travis26pdx/LowPowerSensorSuite/images/PCB_v1.0_build.jpg

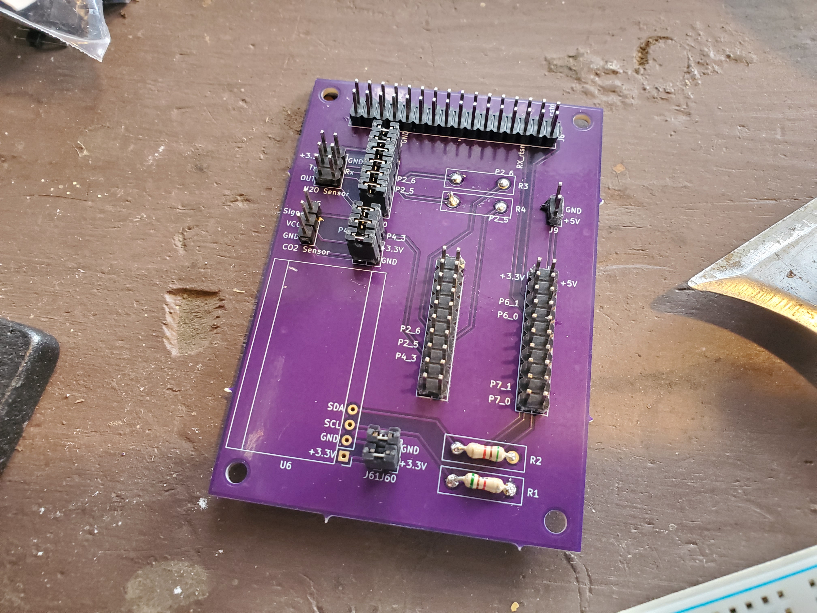
images/PCB_v1.0_build.jpg
