travis26pdx/LowPowerSensorSuite/images/20220415_EnergyTrace_setup.jpg

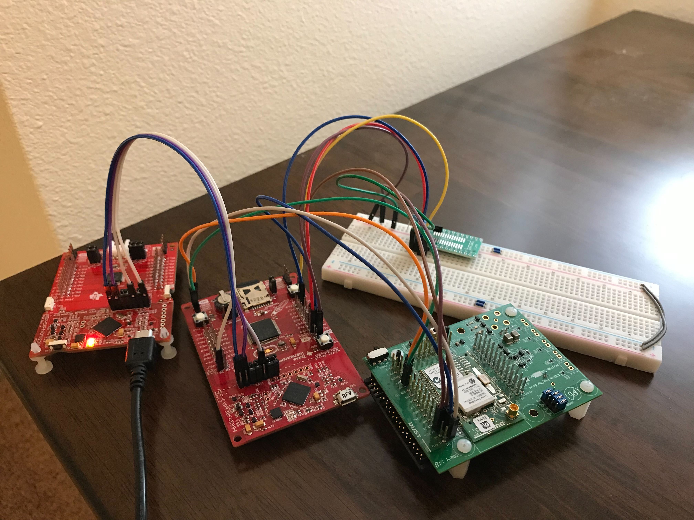
images/20220415_EnergyTrace_setup.jpg
