travis26pdx/LowPowerSensorSuite/README.md

# LowPowerSensorSuite
Repository for 2022 Capstone: 2nd Gen Low Power Environmental Sensor Suite

# Contents
The following are the contents of this repository.
