travis26pdx/LowPowerSensorSuite/Design/readme.md

These folders contain the design files including:
1. KiCad files
2. CAD file for base board
