travis26pdx/LowPowerSensorSuite/Documentation/GANTT_ledger.pdf

1 3 | 10 | 17 | 24 | 31 | 7 | 14 | 21 | 28 | 7 | 14 | 21 | 28 | 4 | 11 | 18 | 25 | 2 | 9 | 16 | 23 | 30 | 6
| | 1/22 | | | | 2/22 | | | | 3/22 | | | | | 4/22 | | | | 5/22 | | | 6/22

## Sensor Suite

Preliminary Research
Review previous Capstone
Write Product Specification
Write Project Proposal
Project Proposal Signed and Submitt...

MSP430
Connect with SmartMesh IP
Code mote to transmit data to co... Connect SmartMesh to MSp430 Code mote to transmit sensor data ... Debug Code
Working Code
Data Storage
Research / Code Proof of concept Data Write / Read
Write sensor data
Debug Code
Final Code
Low Power mode
Research / Code Proof of concept Wake / Sleep cycle
Optimize and Debug Code
Final Code

Code Full Cycle Program
Rough full cycle
Debugged and Optimized
Final code

GUI Development
GUI displays live data
Display timestamps for data
Display status of operation of motes Display Graphical representation of ... Debug Code
Final Code

Sensors
Get Sensor Data
Get temp/humidity data from sens... Get NO2 data from sensor
Characterize sensors
Characterize temp/humidity sensors Characterize NO2 sensor

Breadboard Prototyping
Rough schematic
Build mote on breadboard
Bill of Materials

PCB Prototyping
Final schematic
PCB Layout
Place 1st order PCBs
Build 1st PCB
Place 2nd order of PCBs (if needed) Build 2nd PCB
Minimal Viable Product

Enclosure
Design weather resistant enclosure Purchase materials
Finalize enclosure
Install mote into enclosure Demonstrable Device

Testing
Write test plans
Perform test plans
Testing Completed

Documentation
Github collab site completed Write rough operations guide Write final operations guide Complete Capstone Poster
Capstone poster event
Produce stakeholder report Write rough final report
Write final report
Final Report Presentation

Preliminary Research
Review previous Capstone :: All
Write Product Specification :: All Write Project Proposal :: All
Project Proposal Signed and Submitted :: All

MSP430
Connect with SmartMesh IP
Code mote to transmit data to computer :: Eyal, Wei Connect SmartMesh to MSp430 :: Eyal, Wei
Code mote to transmit sensor data from MSP430 to PC :: Eyal, Wei Debug Code :: Eyal, Wei
Working Code :: Eyal, Wei
Data Storage
Research / Code Proof of concept :: Travis, Wei Data Write / Read :: Travis, Wei
Write sensor data :: Travis, Wei Debug Code :: Travis, Wei
Final Code :: Travis, Wei
Low Power mode
Research / Code Proof of concept :: Travis, Wei Wake / Sleep cycle :: Travis, Wei
Optimize and Debug Code :: Travis, Wei Final Code :: Travis, Wei

Code Full Cycle Program
Rough full cycle :: Travis, Wei
Debugged and Optimized :: Travis, Wei Final code

GUI Development
GUI displays live data :: Eyal, Wenyu
Display timestamps for data :: Eyal, Wenyu Display status of operation of motes :: Eyal, Wenyu Display Graphical representation of data :: Eyal, Wenyu Debug Code :: Eyal, Wenyu
Final Code :: Eyal, Wenyu

Sensors
Get Sensor Data
Get temp/humidity data from sensors :: Wenyu Get NO2 data from sensor :: Wenyu
Characterize sensors
Characterize temp/humidity sensors :: Wenyu Characterize NO2 sensor :: Wenyu

Breadboard Prototyping
Rough schematic :: Travis, Wei
Build mote on breadboard :: Travis, Wei Bill of Materials :: Travis

PCB Prototyping
Final schematic :: Travis, Wei
PCB Layout :: Travis, Wei
Place 1st order PCBs :: Travis
Build 1st PCB :: All
Place 2nd order of PCBs (if needed) :: Travis Build 2nd PCB :: All
Minimal Viable Product :: All

Enclosure
Design weather resistant enclosure :: Wenyu Purchase materials :: Wenyu
Finalize enclosure :: Wenyu Install mote into enclosure :: Wenyu Demonstrable Device

Testing
Write test plans :: Eyal, Wenyu Perform test plans :: Eyal, Wenyu Testing Completed :: Eyal, Wenyu

Documentation
Github collab site completed :: All Write rough operations guide :: All Write final operations guide :: All Complete Capstone Poster :: All Capstone poster event
Produce stakeholder report :: All
Write rough final report :: All Write final report :: All
Final Report Presentation

Powered by TCPDF (www.tcpdf.org)
