travis26pdx/LowPowerSensorSuite/N2O/P2.5&P2.6 serial port configuration document.pdf

Connect the serial port module and MSP430 to the computer, connect TX to 2.6, RX to 2.5, connect to GND, and do not connect the rest of the wires.

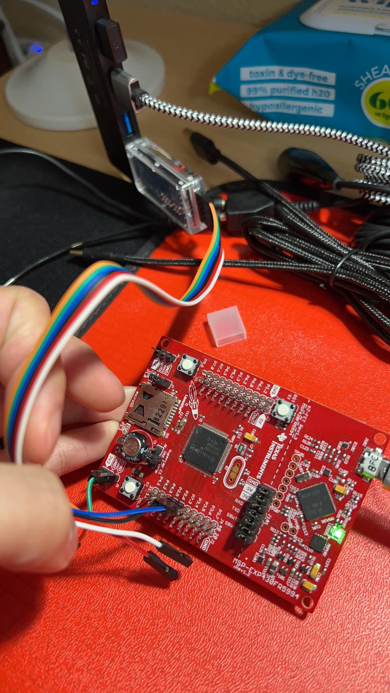
[picture p13: figure]
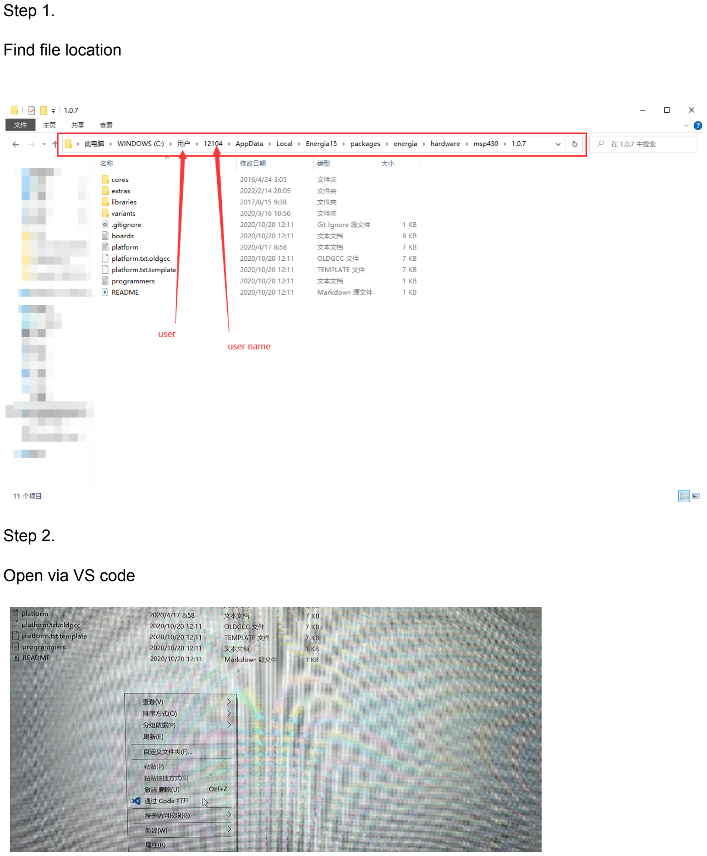
[picture p14: page 2]

Step 1.

Find file location

Step 2.

Open via VS code

Step 3.

variants→MSP-EXP430FR5994LP→pins_energia.h→line 97 & 98

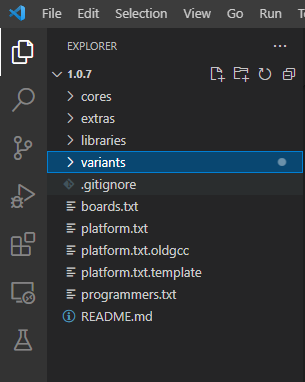
[picture p15: figure]
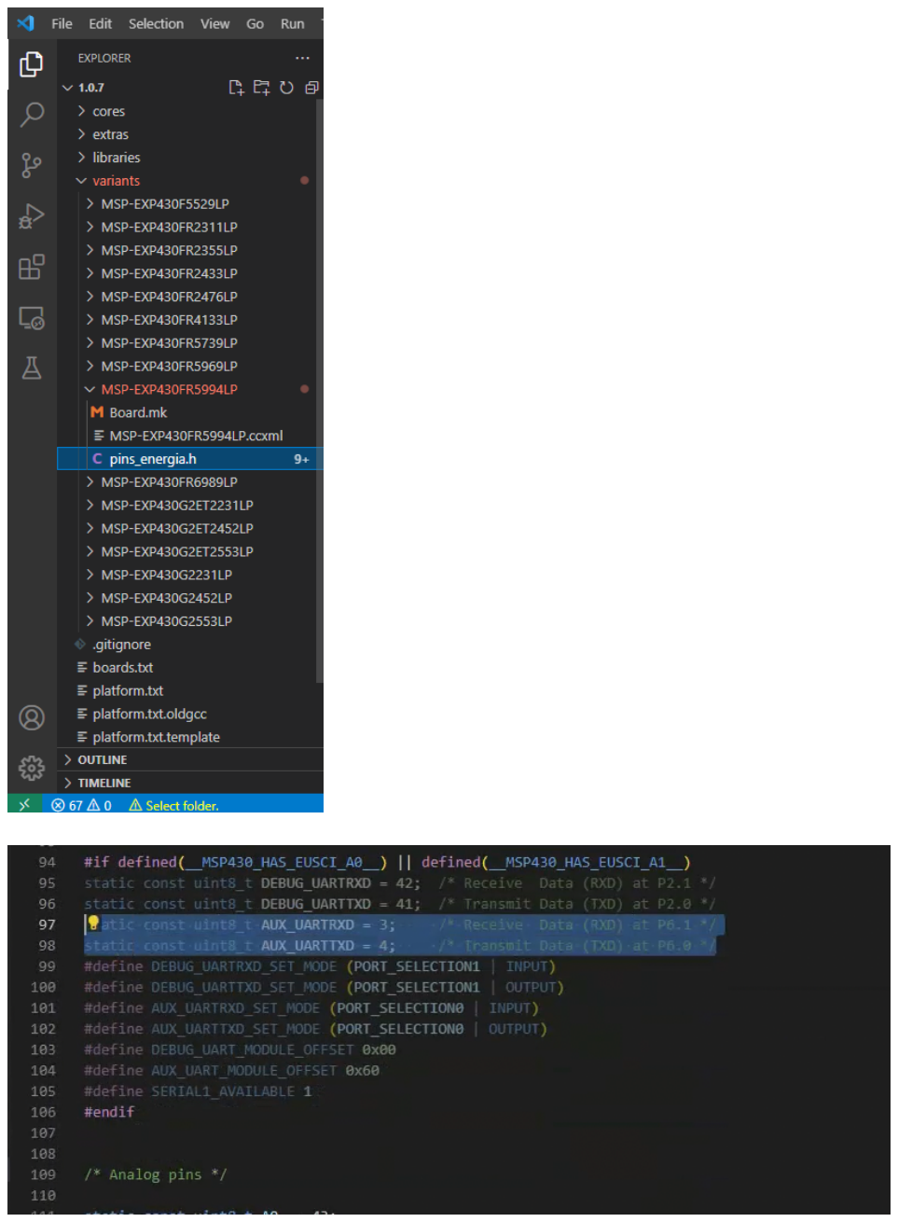
[picture p16: page 4]
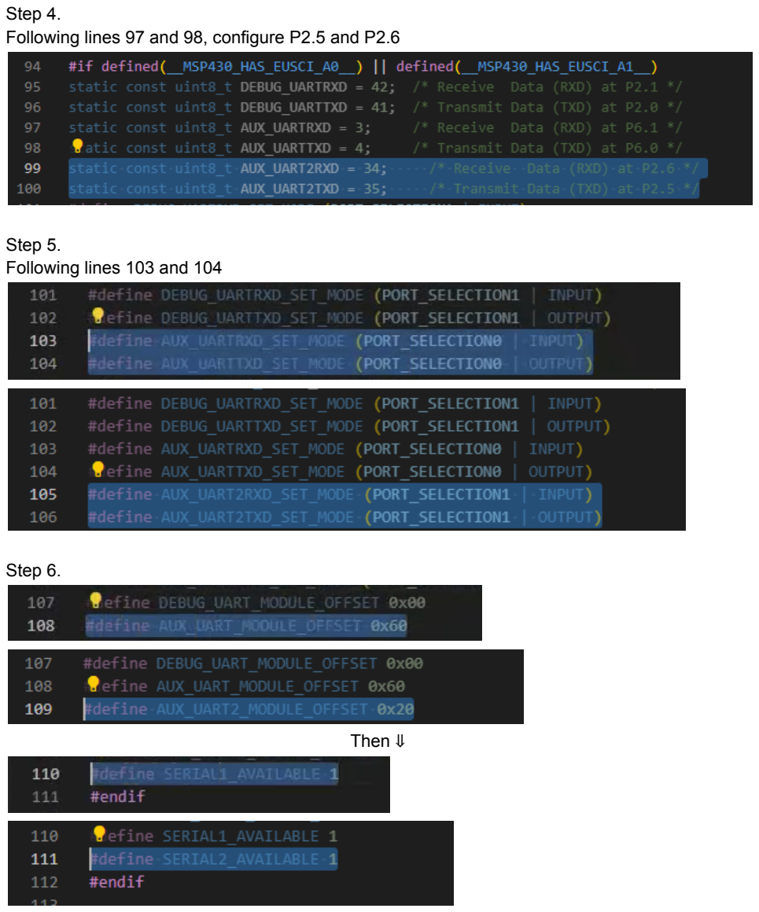
[picture p17: page 5]

Step 4.
Following lines 97 and 98, configure P2.5 and P2.6
Step 5.
Following lines 103 and 104
Step 6.

Then ⇓

Step 7.
cores →HardwareSerial.cpp→line 87-90

⇓

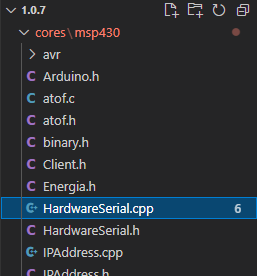
[picture p18: figure]
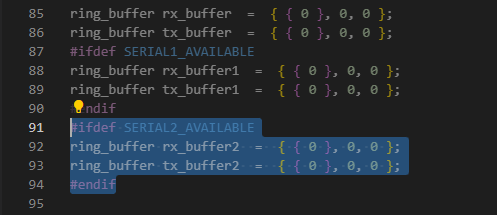
[picture p19: figure]
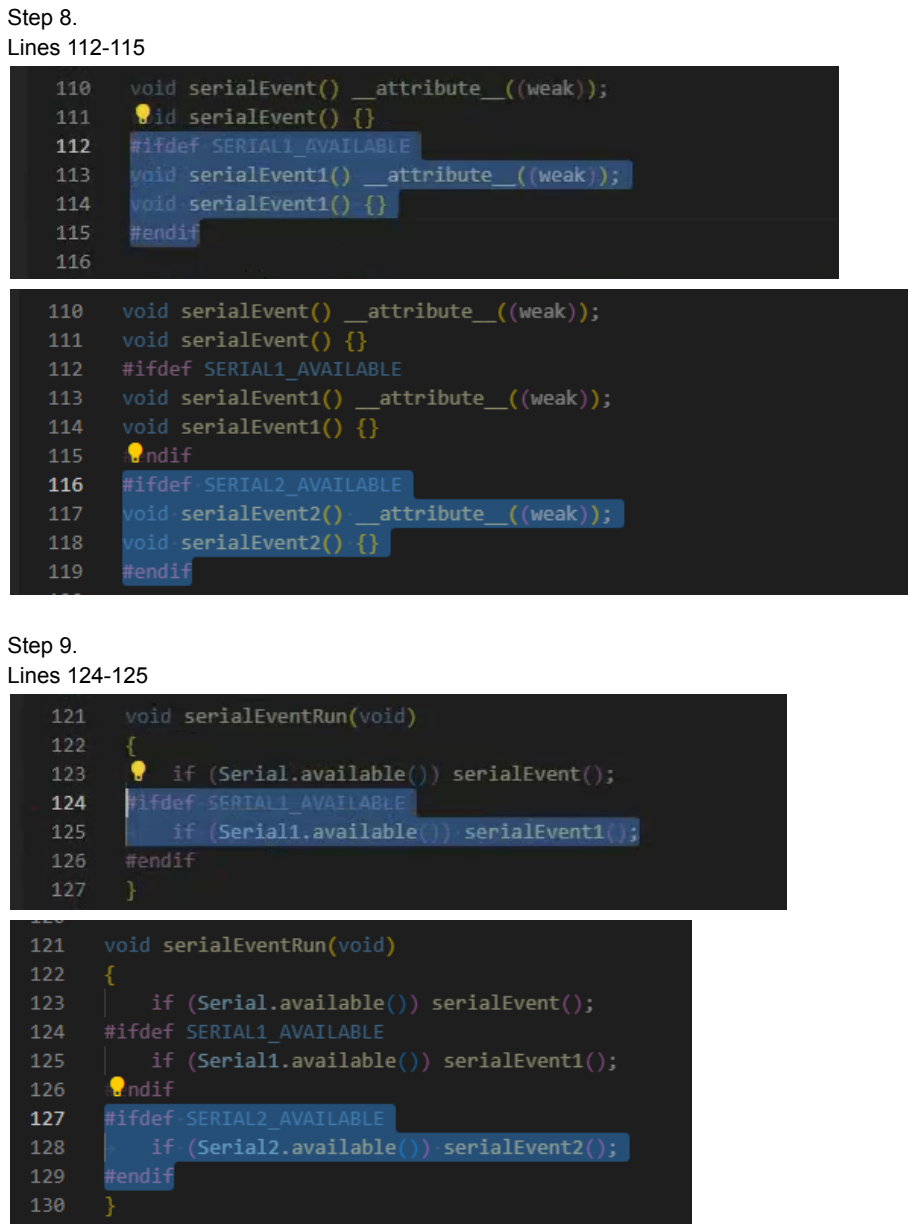
[picture p20: page 7]

Step 8.
Lines 112-115
Step 9.
Lines 124-125

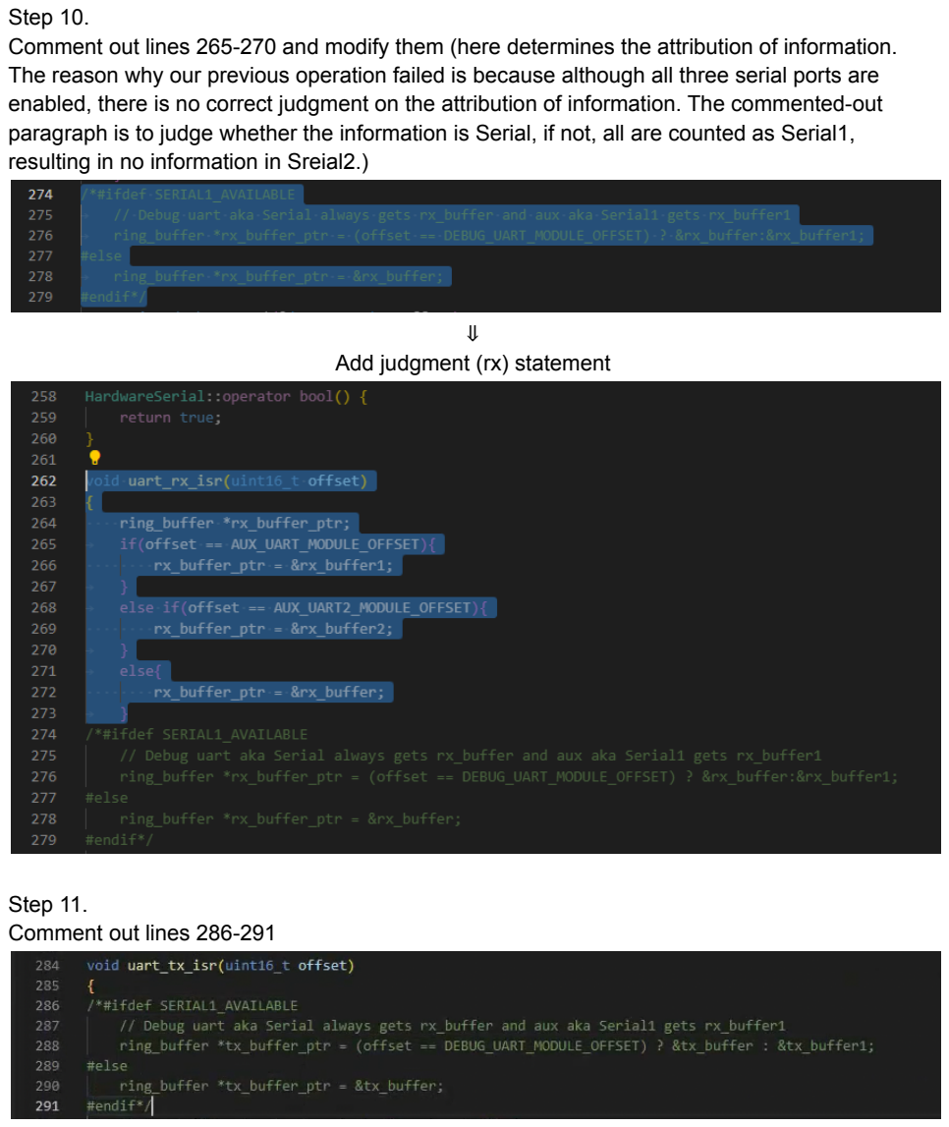
[picture p21: page 8]

Step 10.
Comment out lines 265-270 and modify them (here determines the attribution of information. The reason why our previous operation failed is because although all three serial ports are enabled, there is no correct judgment on the attribution of information. The commented-out paragraph is to judge whether the information is Serial, if not, all are counted as Serial1, resulting in no information in Sreial2.)

⇓
Add judgment (rx) statement
Step 11.
Comment out lines 286-291

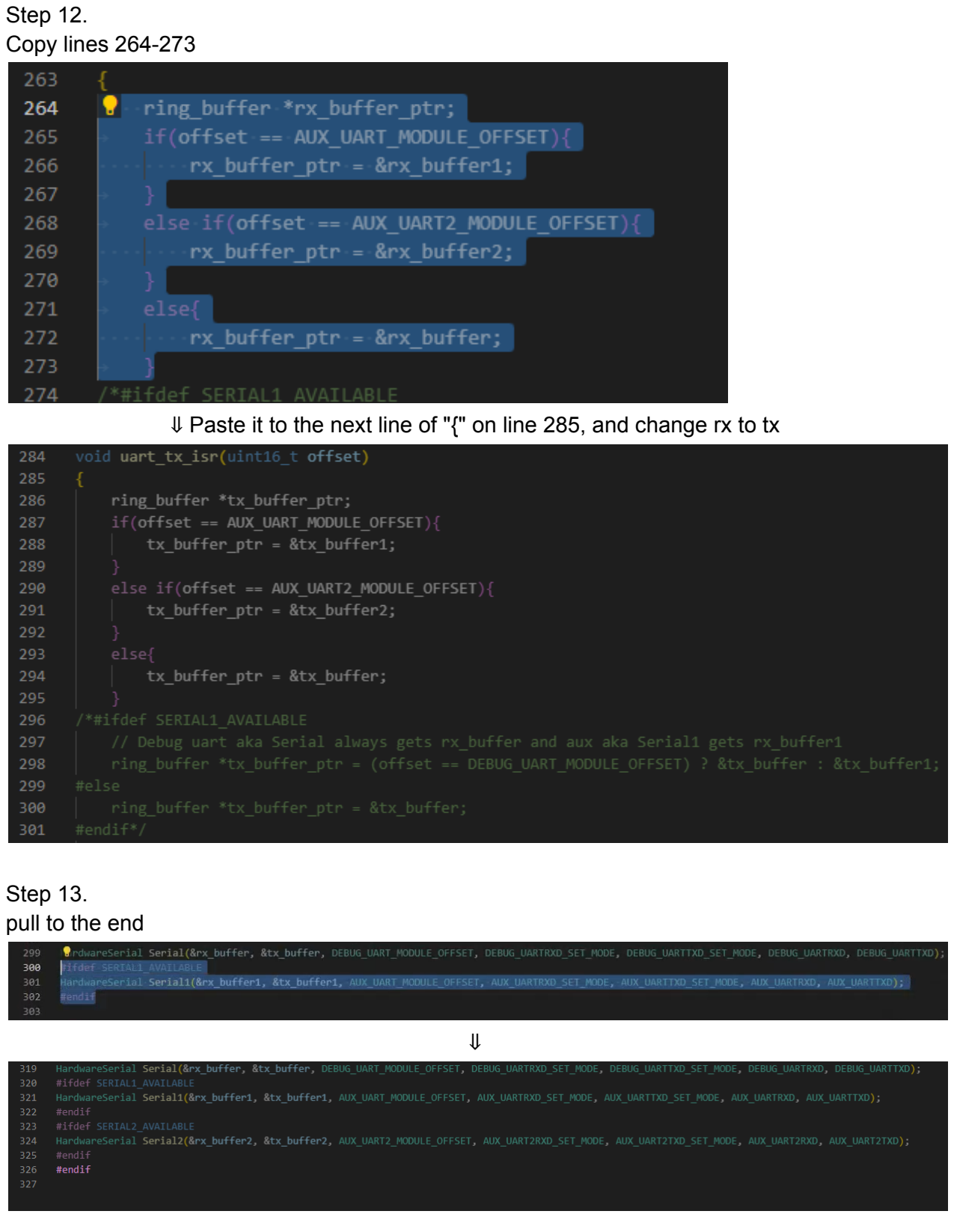
[picture p22: page 9]

Step 12.
Copy lines 264-273

⇓ Paste it to the next line of "{" on line 285, and change rx to tx

Step 13.
pull to the end

⇓

Step 14.
HardwareSerial.h→line 100

⇓

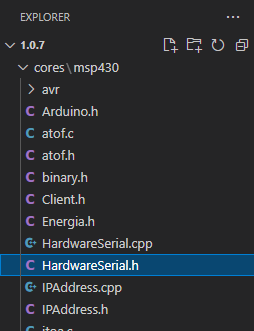
[picture p23: figure]
