travis26pdx/LowPowerSensorSuite/Documentation/PreviousYear/readme.md

This folder contains the deliverables from last year's Capstone team who built the 1st Gen low power environmental sensor suite.
