travis26pdx/LowPowerSensorSuite/Design/baseboard_mm.png

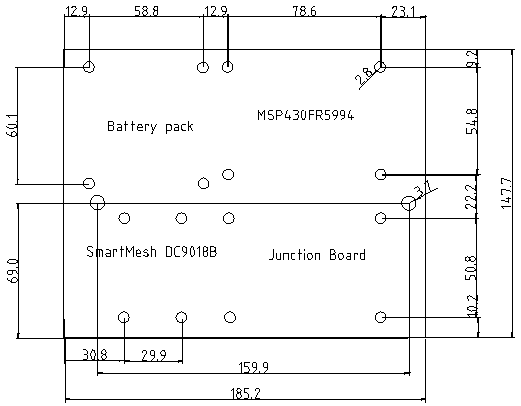
Design/baseboard_mm.png
