travis26pdx/LowPowerSensorSuite/images/20220415_EnergyTrace_Graph.PNG

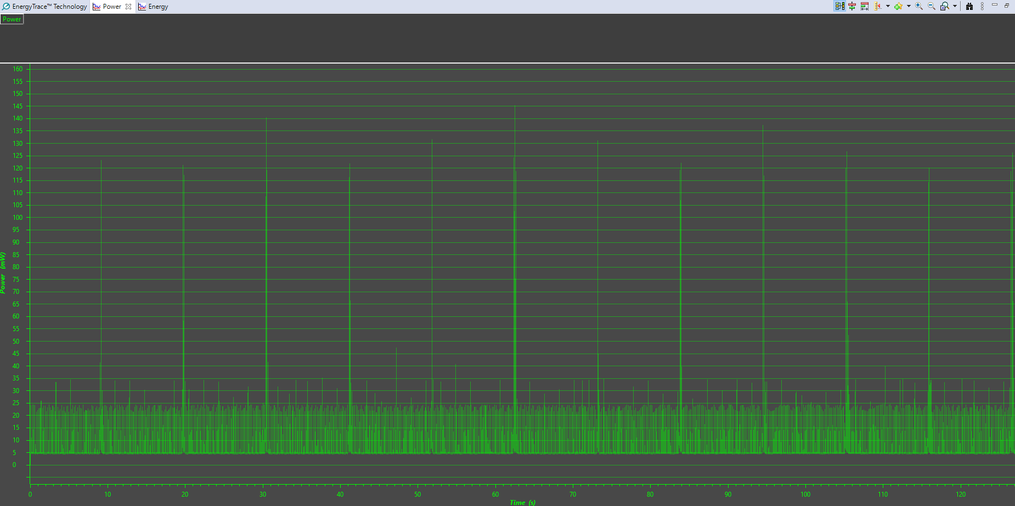
images/20220415_EnergyTrace_Graph.PNG
