travis26pdx/LowPowerSensorSuite/images/circuitboard.png

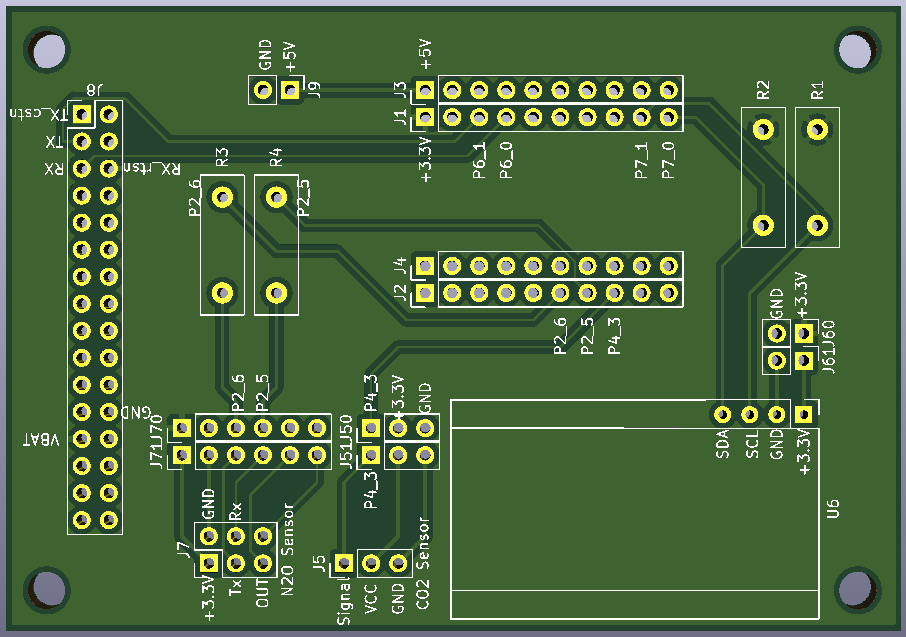
images/circuitboard.png
