travis26pdx/LowPowerSensorSuite/images/complete_mote.jpg

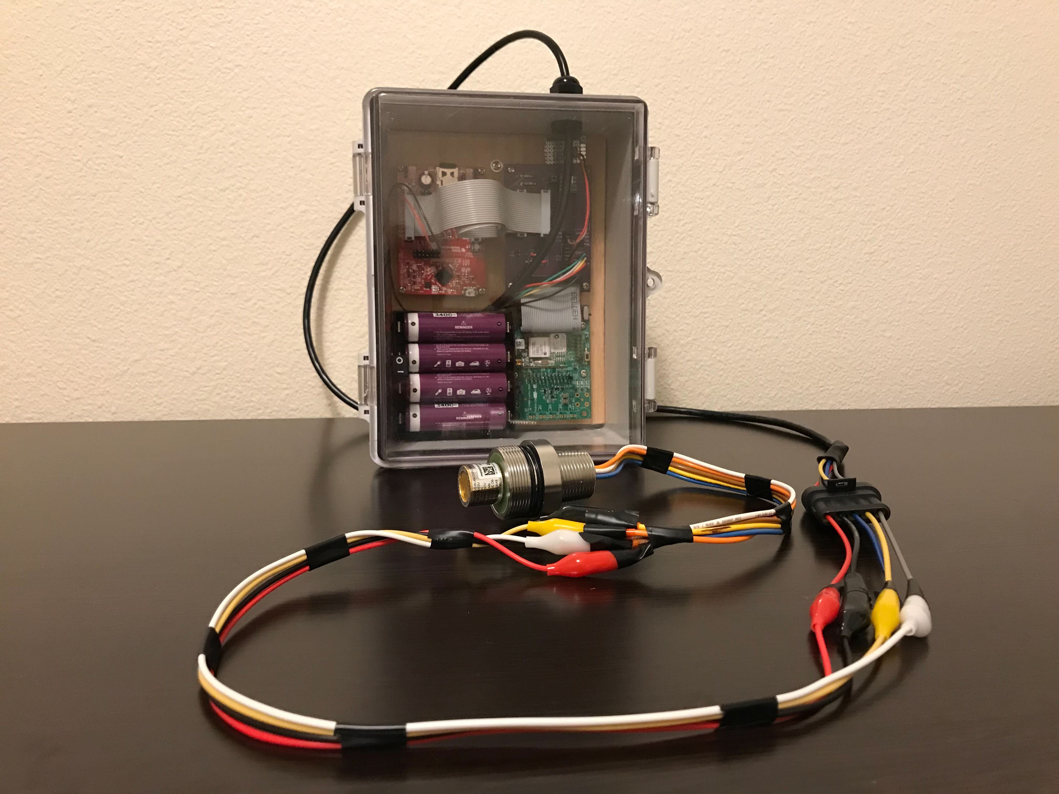
images/complete_mote.jpg
