travis26pdx/LowPowerSensorSuite/images/fullmote01.jpg

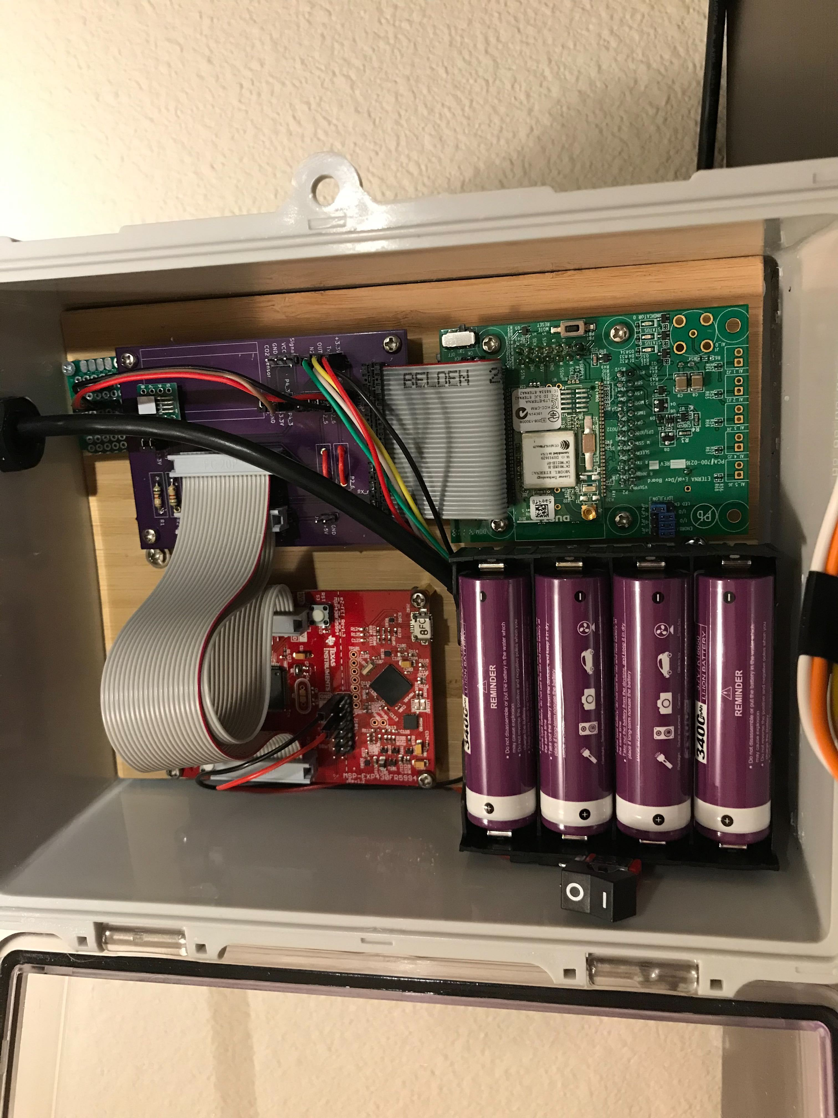
images/fullmote01.jpg
