travis26pdx/LowPowerSensorSuite/BOM/readme.md

This folder contains 2 Bills of Materials.
1. BOM for the entire project
2. BOM for the PCB
