travis26pdx/LowPowerSensorSuite/Design/SensorSuiteBoard/pcb.pdf

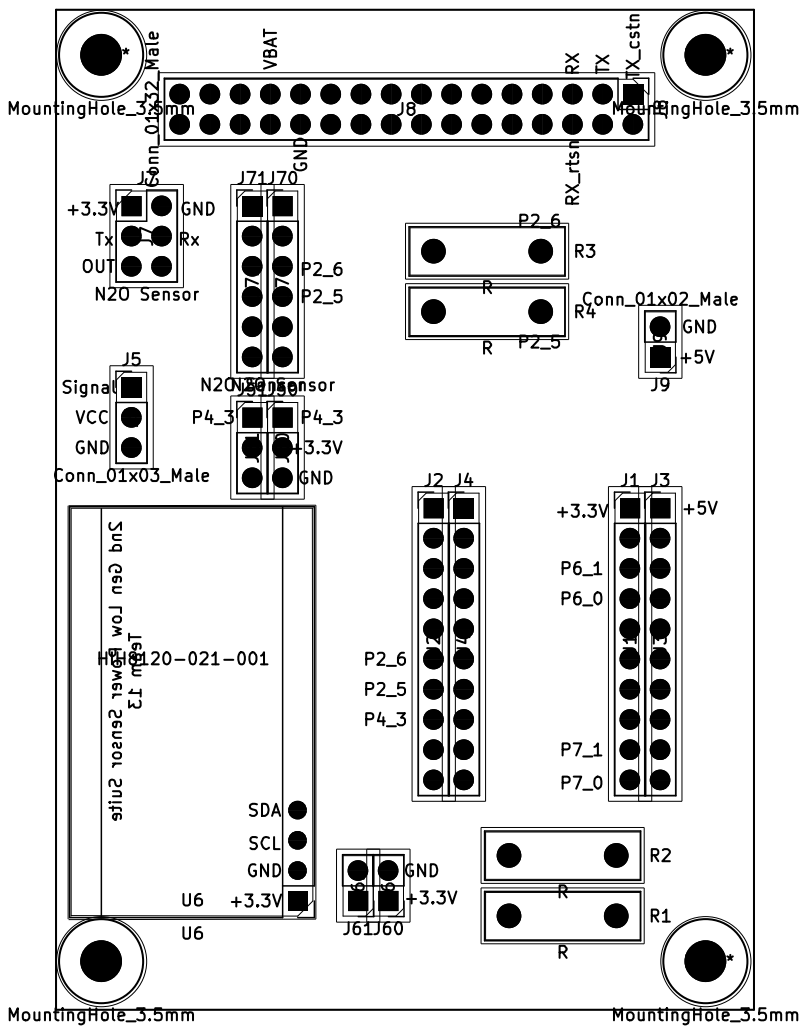
[picture p29: page 1]
