travis26pdx/LowPowerSensorSuite/Design/SensorSuiteBoard/SensorSuiteBoard.kicad_pcb

## KiCad design Design/SensorSuiteBoard/SensorSuiteBoard.kicad_pcb (2022-06-10)

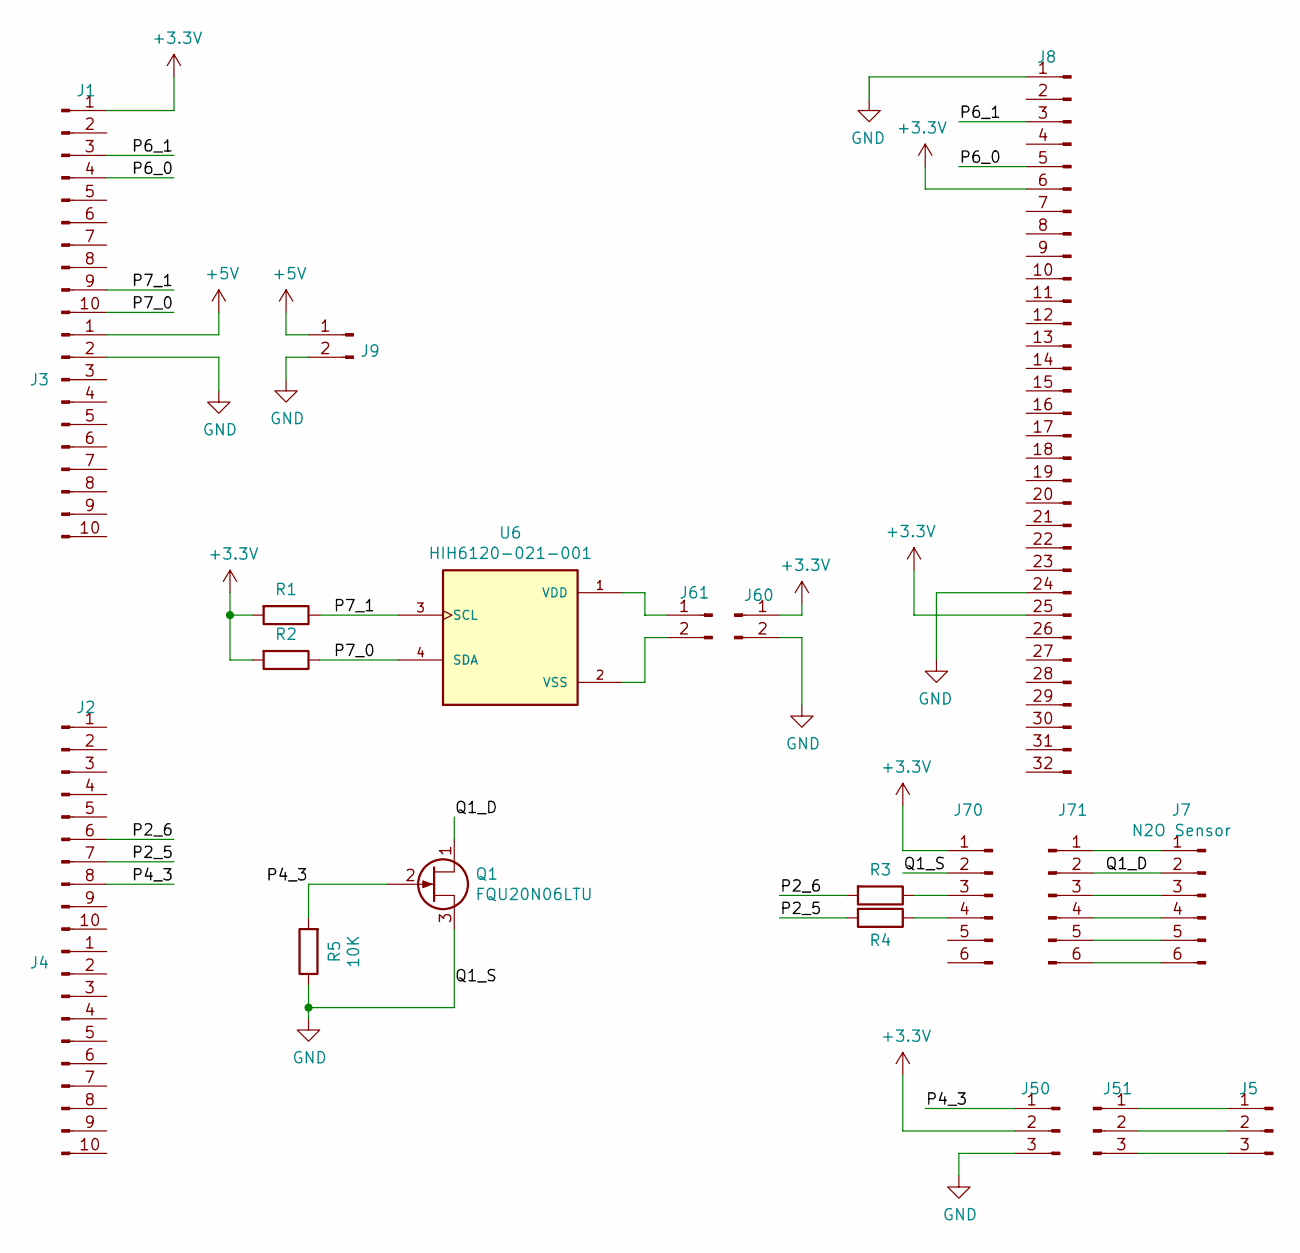
[picture p30: schematic SensorSuiteBoard.sch, Low Power Sensor Suite Junction Board]

Parts:
J1, J2, J3, J4: Conn_01x10_Male; Pin_Header_Straight_1x10_Pitch2.54mm
J5, J50, J51: Conn_01x03_Male; Pin_Header_Straight_1x03_Pitch2.54mm
J7: N2O Sensor; Pin_Header_Straight_2x03_Pitch2.54mm
J8: Conn_01x32_Male; Pin_Header_Straight_2x16_Pitch2.54mm
J9, J60, J61: Conn_01x02_Male; Pin_Header_Straight_1x02_Pitch2.54mm
J70, J71: N2O Sensor; Pin_Header_Straight_1x06_Pitch2.54mm
Q1: FQU20N06LTU
R1, R2, R3, R4: R; R_Box_L13.0mm_W4.0mm_P9.00mm
R5: 10K; R_Box_L13.0mm_W4.0mm_P9.00mm
U6: HIH6120-021-001; HIH8120_breakout

Connections:
+3V3: J1.1, J8.6, J8.25, J50.2, J60.1, J70.1, R1.2, R2.2
+5V: J3.1, J9.1
/P2_5: J2.7, R4.2
/P2_6: J2.6, R3.2
/P4_3: J2.8, J50.1, Q1.2 (G), R5.2
/P6_0: J1.4, J8.5
/P6_1: J1.3, J8.3
/P7_0: J1.10, R2.1, U6.4 (SDA)
/P7_1: J1.9, R1.1, U6.3 (SCL)
GND: J3.2, J8.1, J8.24, J9.2, J50.3, J60.2, J70.2, Q1.3 (S), R5.1
unnamed: J5.1, J51.1
unnamed: J5.2, J51.2
unnamed: J5.3, J51.3
unnamed: J7.1, J71.1
unnamed: J7.2, J71.2, Q1.1 (D)
unnamed: J7.3, J71.3
unnamed: J7.4, J71.4
unnamed: J7.5, J71.5
unnamed: J7.6, J71.6
unnamed: J61.1, U6.1 (VDD)
unnamed: J61.2, U6.2 (VSS)
unnamed: J70.3, R3.1
unnamed: J70.4, R4.1

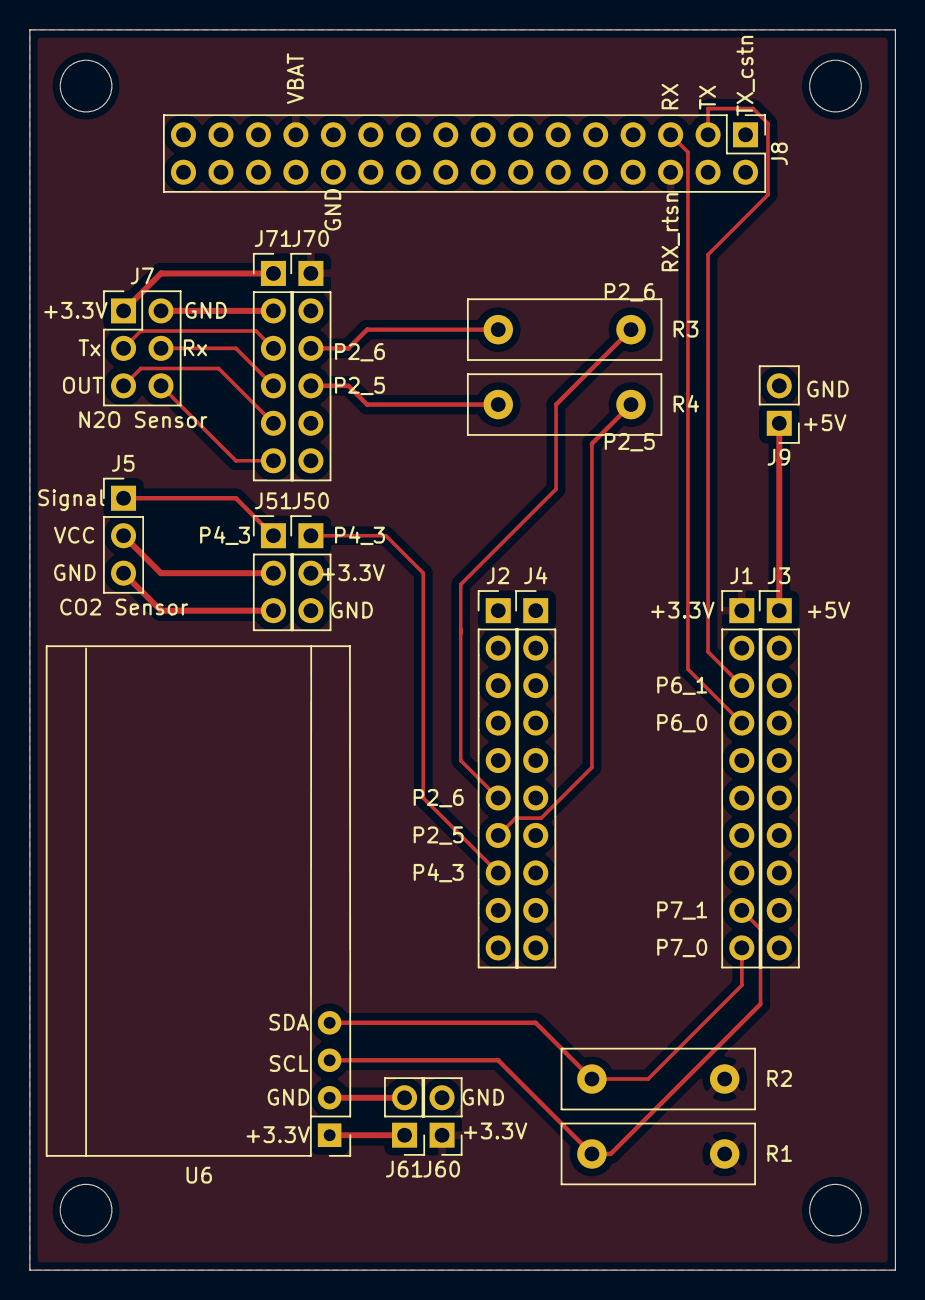
[picture p31: board SensorSuiteBoard.kicad_pcb from above]

Board: 2 copper layers, 58.7 x 84.1 mm, 19 parts (0 on the bottom side), 23 nets.
