travis26pdx/LowPowerSensorSuite/Firmware/Temp Humidity Sensor Fix/msp430-lg-core-master/variants/MSP-EXP430FR2355LP/pins_energia.h

#define Pins_Energia_h
#define BV(x) (1 << (x))
#include <msp430fr2xx_4xxgeneric.h>
#define PLACE_IN_FRAM __attribute__((section(".text;")))
#if defined(__MSP430_HAS_EUSCI_B0__)
static const uint8_t SS1      = 8;
static const uint8_t SCK1     = 7;
static const uint8_t MOSI1    = 15;
static const uint8_t MISO1    = 14;
static const uint8_t TWISCL0  = 9;
static const uint8_t TWISDA0  = 10;
static const uint8_t TWISDA1  = 15;
static const uint8_t TWISCL1  = 14;
#define TWISDA0_SET_MODE  (PORT_SELECTION0 | INPUT_PULLUP)
#define TWISCL0_SET_MODE  (PORT_SELECTION0 | INPUT_PULLUP)
#define TWISDA1_SET_MODE  (PORT_SELECTION0 | INPUT_PULLUP)
#define TWISCL1_SET_MODE  (PORT_SELECTION0 | INPUT_PULLUP)
#define SPISCK1_SET_MODE  (PORT_SELECTION0)
#define SPIMOSI1_SET_MODE (PORT_SELECTION0)
#define SPIMISO1_SET_MODE (PORT_SELECTION0)
#define DEFAULT_SPI 1
#define SS    SS1
#define SCK   SCK1
#define MOSI  MOSI1
#define MISO  MISO1
#define SPISCK_SET_MODE  SPISCK1_SET_MODE
#define SPIMOSI_SET_MODE SPIMOSI1_SET_MODE
#define SPIMISO_SET_MODE SPIMISO1_SET_MODE
#define DEFAULT_I2C 0
#define TWISDA TWISDA0
#define TWISCL TWISCL0
#define TWISDA_SET_MODE  TWISDA0_SET_MODE
#define TWISCL_SET_MODE  TWISCL0_SET_MODE
#endif
#if defined(__MSP430_HAS_EUSCI_A0__) || defined(__MSP430_HAS_EUSCI_A1__)
static const uint8_t DEBUG_UARTRXD = 42;
static const uint8_t DEBUG_UARTTXD = 41;
static const uint8_t AUX_UARTRXD = 3;
static const uint8_t AUX_UARTTXD = 4;
#define DEBUG_UARTRXD_SET_MODE (PORT_SELECTION0 | INPUT)
#define DEBUG_UARTTXD_SET_MODE (PORT_SELECTION0 | OUTPUT)
#define AUX_UARTRXD_SET_MODE (PORT_SELECTION0 | INPUT)
#define AUX_UARTTXD_SET_MODE (PORT_SELECTION0 | OUTPUT)
#define DEBUG_UART_MODULE_OFFSET 0x80
#define AUX_UART_MODULE_OFFSET 0x00
#define SERIAL1_AVAILABLE 1
#endif
#define DEFAULT_TIMER 13
#define INIT_LFXTAL_PINS P2SEL0 = BIT6 | BIT7
static const uint8_t A0  = 43;
static const uint8_t A1  = 28;
static const uint8_t A2  = 10;
static const uint8_t A3  = 9;
static const uint8_t A4  = 23;
static const uint8_t A5  = 2;
static const uint8_t A6  = 3;
static const uint8_t A7  = 4;
static const uint8_t A8  = 26;
static const uint8_t A9  = 25;
static const uint8_t A10 = 6;
static const uint8_t A11 = 24;
static const uint8_t A12 = 128 + 12; // Not available on BoosterPack header
static const uint8_t A13 = 128 + 13; // Not available on BoosterPack header
static const uint8_t A14 = 128 + 14; // Not available on BoosterPack header
static const uint8_t A15 = 128 + 15; // Not available on BoosterPack header
static const uint8_t P1_0 = 43;
static const uint8_t P1_1 = 28;
static const uint8_t P1_2 = 10;
static const uint8_t P1_3 = 9;
static const uint8_t P1_4 = 23;
static const uint8_t P1_5 = 2;
static const uint8_t P1_6 = 3;
static const uint8_t P1_7 = 4;
static const uint8_t P2_0 = 19;
static const uint8_t P2_1 = 40;
static const uint8_t P2_2 = 18;
static const uint8_t P2_3 = 46;
static const uint8_t P2_4 = 33;
static const uint8_t P2_5 = 12;
static const uint8_t P3_0 = 11;
static const uint8_t P3_1 = 30;
static const uint8_t P3_2 = 31;
static const uint8_t P3_3 = 32;
static const uint8_t P3_4 = 8;
static const uint8_t P3_5 = 29;
static const uint8_t P3_6 = 5;
static const uint8_t P3_7 = 34;
static const uint8_t P4_0 = 17;
static const uint8_t P4_1 = 45;
static const uint8_t P4_2 = 42;
static const uint8_t P4_3 = 41;
static const uint8_t P4_4 = 13;
static const uint8_t P4_5 = 7;
static const uint8_t P4_6 = 15;
static const uint8_t P4_7 = 14;
static const uint8_t P5_0 = 26;
static const uint8_t P5_1 = 25;
static const uint8_t P5_2 = 6;
static const uint8_t P5_3 = 24;
static const uint8_t P5_4 = 27;
static const uint8_t P6_0 = 39;
static const uint8_t P6_1 = 38;
static const uint8_t P6_2 = 37;
static const uint8_t P6_3 = 36;
static const uint8_t P6_4 = 35;
static const uint8_t P6_6 = 44;
static const uint8_t LED1 = 43;
static const uint8_t LED2 = 44;
static const uint8_t RED_LED = 43;
static const uint8_t GREEN_LED = 44;
static const uint8_t PUSH1 = 45;
static const uint8_t PUSH2 = 46;
static const uint8_t TEMPSENSOR = 128 + 12; // depends on chip
#ifdef ARDUINO_MAIN
const uint16_t port_to_input[] = {
   NOT_A_PORT,
   (uint16_t) (P1_BASE+OFS_P1IN),
   (uint16_t) (P2_BASE+OFS_P2IN),
#ifdef __MSP430_HAS_PORT3_R__
   (uint16_t) (P3_BASE+OFS_P3IN),
#endif
#ifdef __MSP430_HAS_PORT4_R__
   (uint16_t) (P4_BASE+OFS_P4IN),
#endif
#ifdef __MSP430_HAS_PORT5_R__
   (uint16_t) (P5_BASE+OFS_P5IN),
#endif
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
        NOT_ON_ADC,
        NOT_ON_ADC,
        NOT_ON_ADC,
        NOT_ON_ADC,
        NOT_ON_ADC,
        NOT_ON_ADC,
        NOT_ON_ADC,
        NOT_ON_ADC,
        NOT_ON_ADC,
        NOT_ON_ADC,
        NOT_ON_ADC,
        0,
        NOT_ON_ADC,
        NOT_ON_ADC,
        NOT_ON_ADC,
};
#endif // #ifdef ARDUINO_MAIN
