travis26pdx/LowPowerSensorSuite/Firmware/Temp Humidity Sensor Fix/msp430-lg-core-master/variants/MSP-EXP430FR2433LP/pins_energia.h

#define Pins_Energia_h
#define BV(x) (1 << (x))
#include <msp430fr2xx_4xxgeneric.h>
#define PLACE_IN_FRAM __attribute__((section(".text;")))
static const uint8_t SS11     = 8;
static const uint8_t SCK11    = 7;
static const uint8_t MOSI11   = 15;
static const uint8_t MISO11   = 14;
static const uint8_t TWISDA0  = 10;
static const uint8_t TWISCL0  = 9;
static const uint8_t TWISDA1  = 15;
static const uint8_t TWISCL1  = 14;
#define TWISDA0_SET_MODE  (PORT_SELECTION0 | INPUT_PULLUP)
#define TWISCL0_SET_MODE  (PORT_SELECTION0 | INPUT_PULLUP)
#define TWISDA1_SET_MODE  (PORT_SELECTION0 | INPUT_PULLUP)
#define TWISCL1_SET_MODE  (PORT_SELECTION0 | INPUT_PULLUP)
#define SPISCK11_SET_MODE  (PORT_SELECTION0)
#define SPIMOSI11_SET_MODE (PORT_SELECTION0)
#define SPIMISO11_SET_MODE (PORT_SELECTION0)
#define DEFAULT_SPI 11
#define SS    SS11
#define SCK   SCK11
#define MOSI  MOSI11
#define MISO  MISO11
#define SPISCK_SET_MODE  SPISCK11_SET_MODE
#define SPIMOSI_SET_MODE SPIMOSI11_SET_MODE
#define SPIMISO_SET_MODE SPIMISO11_SET_MODE
static const uint8_t SS10     = 6;
static const uint8_t SCK10    = 5;
static const uint8_t MOSI10   = 4;
static const uint8_t MISO10   = 3;
#define SPISCK10_SET_MODE  (PORT_SELECTION0)
#define SPIMOSI10_SET_MODE (PORT_SELECTION0)
#define SPIMISO10_SET_MODE (PORT_SELECTION0)
#define DEFAULT_I2C 0
#define LEGACY_I2C  -1
#define TWISDA TWISDA0
#define TWISCL TWISCL0
#define TWISDA_SET_MODE  TWISDA0_SET_MODE
#define TWISCL_SET_MODE  TWISCL0_SET_MODE
#if defined(__MSP430_HAS_EUSCI_A0__) || defined(__MSP430_HAS_EUSCI_A1__)
static const uint8_t DEBUG_UARTRXD = 3;
static const uint8_t DEBUG_UARTTXD = 4;
static const uint8_t AUX_UARTRXD = 14;
static const uint8_t AUX_UARTTXD = 15;
#define DEBUG_UARTRXD_SET_MODE (PORT_SELECTION0 | INPUT)
#define DEBUG_UARTTXD_SET_MODE (PORT_SELECTION0 | OUTPUT)
#define DEBUG_UART_MODULE_OFFSET 0x00
#define AUX_UARTRXD_SET_MODE (PORT_SELECTION0 | INPUT)
#define AUX_UARTTXD_SET_MODE (PORT_SELECTION0 | OUTPUT)
#define AUX_UART_MODULE_OFFSET 0x20
#define SERIAL1_AVAILABLE 1
#endif
#define INIT_LFXTAL_PINS 	P2SEL0 = BIT0 | BIT1
static const uint8_t P1_0 = 2;
static const uint8_t P1_1 = 19;
static const uint8_t P1_2 = 10;
static const uint8_t P1_3 = 9;
static const uint8_t P1_4 = 4;
static const uint8_t P1_5 = 3;
static const uint8_t P1_6 = 5;
static const uint8_t P1_7 = 6;
static const uint8_t P2_0 = 11;
static const uint8_t P2_1 = 12;
static const uint8_t P2_2 = 18;
static const uint8_t P2_3 = 21;
static const uint8_t P2_4 = 7;
static const uint8_t P2_5 = 14;
static const uint8_t P2_6 = 15;
static const uint8_t P2_7 = 8;
static const uint8_t P3_0 = 22;
static const uint8_t P3_1 = 13;
static const uint8_t P3_2 = 17;
static const uint8_t LED1 = 2;
static const uint8_t LED2 = 19;
static const uint8_t RED_LED = 2;
static const uint8_t GREEN_LED = 19;
static const uint8_t PUSH1 = 21;
static const uint8_t PUSH2 = 8;
static const uint8_t TEMPSENSOR = 128 + 12; // depends on chip
static const uint8_t A0  = 2;
static const uint8_t A1  = 19;
static const uint8_t A2  = 10;
static const uint8_t A3  = 9;
static const uint8_t A4  = 4;
static const uint8_t A5  = 3;
static const uint8_t A6  = 5;
static const uint8_t A7  = 6;
static const uint8_t A8  = 128 + 8;  // Not available on FR2433
static const uint8_t A9  = 128 + 9;  // Not available on FR2433
static const uint8_t A10 = 128 + 10; // Not available on FR2433
static const uint8_t A11 = 128 + 11; // Not available on FR2433
static const uint8_t A12 = 128 + 12; // Not available on FR2433
static const uint8_t A13 = 128 + 13; // Not available on FR2433
static const uint8_t A14 = 128 + 14; // Not available on FR2433
static const uint8_t A15 = 128 + 15; // Not available on FR2433
#ifdef ARDUINO_MAIN
const uint16_t port_to_input[] = {
    NOT_A_PORT,
    (uint16_t) &P1IN,
    (uint16_t) &P2IN,
#ifdef __MSP430_HAS_PORT3_R__
    (uint16_t) &P3IN,
#endif
#ifdef __MSP430_HAS_PORT4_R__
    (uint16_t) &P4IN,
#endif
#ifdef __MSP430_HAS_PORT5_R__
    (uint16_t) &P5IN,
#endif
#ifdef __MSP430_HAS_PORT6_R__
    (uint16_t) &P6IN,
#endif
#ifdef __MSP430_HAS_PORT7_R__
    (uint16_t) &P7IN,
#endif
#ifdef __MSP430_HAS_PORT8_R__
    (uint16_t) &P8IN,
#endif
#ifdef __MSP430_HAS_PORTJ_R__
    (uint16_t) &PJIN,
#endif
};
const uint16_t port_to_output[] = {
    NOT_A_PORT,
    (uint16_t) &P1OUT,
    (uint16_t) &P2OUT,
#ifdef __MSP430_HAS_PORT3_R__
    (uint16_t) &P3OUT,
#endif
#ifdef __MSP430_HAS_PORT4_R__
    (uint16_t) &P4OUT,
#endif
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
    0,
    5,
    4,
    6,
    7,
    NOT_ON_ADC,
    NOT_ON_ADC,
    3,
    2,
    NOT_ON_ADC,
    NOT_ON_ADC,
    NOT_ON_ADC,
    NOT_ON_ADC,
    NOT_ON_ADC,
    NOT_ON_ADC,
    NOT_ON_ADC,
    NOT_ON_ADC,
    1,
    NOT_ON_ADC,
    NOT_ON_ADC,
    NOT_ON_ADC,
};
#endif // #ifdef ARDUINO_MAIN
