travis26pdx/LowPowerSensorSuite/Firmware/Temp Humidity Sensor Fix/msp430-lg-core-master/variants/MSP-EXP430FR2476LP/pins_energia.h

#define Pins_Energia_h
#define BV(x) (1 << (x))
#include <msp430fr2xx_4xxgeneric.h>
#define PLACE_IN_FRAM __attribute__((section(".text#")))
#if defined(__MSP430_HAS_EUSCI_B0__)
static const uint8_t SS0       = 27;
static const uint8_t SCK0      = 28;
static const uint8_t MOSI0     = 10;
static const uint8_t MISO0     = 9;
static const uint8_t SS1       = 8;
static const uint8_t SCK1      = 7;
static const uint8_t MOSI1     = 15;
static const uint8_t MISO1     = 14;
static const uint8_t TWISDA0  = 10;
static const uint8_t TWISCL0  = 9;
static const uint8_t TWISDA1  = 15;
static const uint8_t TWISCL1  = 14;
#define TWISDA0_SET_MODE (PORT_SELECTION0 | INPUT_PULLUP)
#define TWISCL0_SET_MODE (PORT_SELECTION0 | INPUT_PULLUP)
#define TWISDA1_SET_MODE (PORT_SELECTION0 | INPUT_PULLUP)
#define TWISCL1_SET_MODE (PORT_SELECTION0 | INPUT_PULLUP)
#define DEFAULT_SPI 1
#define SS    SS1
#define SCK   SCK1
#define MOSI  MOSI1
#define MISO  MISO1
#define SPISCK_SET_MODE  SPISCK1_SET_MODE
#define SPIMOSI_SET_MODE SPIMOSI1_SET_MODE
#define SPIMISO_SET_MODE SPIMISO1_SET_MODE
#define SPISCK0_SET_MODE  (PORT_SELECTION0)
#define SPIMOSI0_SET_MODE (PORT_SELECTION0)
#define SPIMISO0_SET_MODE (PORT_SELECTION0)
#define SPISCK1_SET_MODE  (PORT_SELECTION0)
#define SPIMOSI1_SET_MODE (PORT_SELECTION0)
#define SPIMISO1_SET_MODE (PORT_SELECTION0)
#define DEFAULT_I2C 0
#define TWISDA TWISDA0
#define TWISCL TWISCL0
#define TWISDA_SET_MODE  TWISDA0_SET_MODE
#define TWISCL_SET_MODE  TWISCL0_SET_MODE
#endif
#if defined(__MSP430_HAS_EUSCI_A0__) || defined(__MSP430_HAS_EUSCI_A1__)
static const uint8_t DEBUG_UARTRXD = 42;
static const uint8_t DEBUG_UARTTXD = 41;
static const uint8_t AUX_UARTRXD = 3;
static const uint8_t AUX_UARTTXD = 4;
#define DEBUG_UARTRXD_SET_MODE (PORT_SELECTION0 | INPUT)
#define DEBUG_UARTTXD_SET_MODE (PORT_SELECTION0 | OUTPUT)
#define AUX_UARTRXD_SET_MODE (PORT_SELECTION0 | INPUT)
#define AUX_UARTTXD_SET_MODE (PORT_SELECTION0 | OUTPUT)
#define DEBUG_UART_MODULE_OFFSET 0x00
#define AUX_UART_MODULE_OFFSET 0x20
#define SERIAL1_AVAILABLE 1
#endif
static const uint8_t A0  = 27;
static const uint8_t A1  = 28;
static const uint8_t A2  = 128 + 2; // Not available on BoosterPack header
static const uint8_t A3  = 128 + 3; // Not available on BoosterPack header
static const uint8_t A4  = 128 + 4; // Not available on BoosterPack header
static const uint8_t A5  = 128 + 5; // Not available on BoosterPack header
static const uint8_t A6  = 2;
static const uint8_t A7  = 23;
static const uint8_t A8  = 24;
static const uint8_t A9  = 25;
static const uint8_t A10 = 26;
static const uint8_t A11 = 6;
static const uint8_t A12 = 128 + 12; // Not available on BoosterPack header
static const uint8_t A13 = 128 + 13; // Not available on BoosterPack header
static const uint8_t A14 = 128 + 14; // Not available on BoosterPack header
static const uint8_t A15 = 128 + 15; // Not available on BoosterPack header
#define INIT_LFXTAL_PINS    P2SEL0 = BIT0 | BIT1
static const uint8_t P1_6 = 2;
static const uint8_t P2_5 = 3;
static const uint8_t P2_6 = 4;
static const uint8_t P2_2 = 5;
static const uint8_t P5_4 = 6;
static const uint8_t P3_5 = 7;
static const uint8_t P4_5 = 8;
static const uint8_t P1_3 = 9;
static const uint8_t P1_2 = 10;
static const uint8_t P2_4 = 11;
static const uint8_t P2_7 = 12;
static const uint8_t P4_2 = 13;
static const uint8_t P3_6 = 14;
static const uint8_t P3_2 = 15;
static const uint8_t P2_0 = 17;
static const uint8_t P2_1 = 18;
static const uint8_t P4_6 = 19;
static const uint8_t P1_7 = 23;
static const uint8_t P4_3 = 24;
static const uint8_t P4_4 = 25;
static const uint8_t P5_3 = 26;
static const uint8_t P1_0 = 27;
static const uint8_t P1_1 = 28;
static const uint8_t P5_7 = 29;
static const uint8_t P3_7 = 30;
static const uint8_t P3_1 = 31;
static const uint8_t P4_1 = 32;
static const uint8_t P6_2 = 33;
static const uint8_t P6_1 = 34;
static const uint8_t P3_3 = 35;
static const uint8_t P6_0 = 36;
static const uint8_t P4_7 = 37;
static const uint8_t P5_0 = 38;
static const uint8_t P5_1 = 39;
static const uint8_t P5_2 = 40;
static const uint8_t P1_4 = 41;
static const uint8_t P1_5 = 42;
static const uint8_t P4_0 = 43;
static const uint8_t P2_3 = 44;
static const uint8_t PUSH1 = 43;
static const uint8_t PUSH2 = 44;
static const uint8_t RED_LED = 39;
static const uint8_t GREEN_LED = 27;
static const uint8_t RED_LED2 = 39;
static const uint8_t GREEN_LED2 = 38;
static const uint8_t BLUE_LED2 = 37;
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
        NOT_ON_ADC,
        NOT_ON_ADC,
        NOT_ON_ADC,
        NOT_ON_ADC,
        NOT_ON_ADC,
        NOT_ON_ADC,
        NOT_ON_ADC,
        NOT_ON_ADC,
        NOT_ON_ADC,
        NOT_ON_ADC,
        NOT_ON_ADC,
        NOT_ON_ADC,
        NOT_ON_ADC,
        NOT_ON_ADC,
        NOT_ON_ADC,
};
#endif // #ifdef ARDUINO_MAIN
