travis26pdx/LowPowerSensorSuite/Firmware/Temp Humidity Sensor Fix/msp430-lg-core-master/variants/MSP-EXP430FR5994LP/pins_energia.h

#define Pins_Energia_h
#define BV(x) (1 << (x))
#define PLACE_IN_FRAM __attribute__((section(".text;")))
#if defined(__MSP430_HAS_EUSCI_B0__)
static const uint8_t SS0     = 47;
static const uint8_t SCK0    = 49;
static const uint8_t MOSI0   = 48;
static const uint8_t MISO0   = 50;
static const uint8_t SS1     = 8;
static const uint8_t SCK1    = 7;
static const uint8_t MOSI1   = 15;
static const uint8_t MISO1   = 14;
static const uint8_t TWISDA0 = 48;
static const uint8_t TWISCL0 = 50;
static const uint8_t TWISDA1 = 15;
static const uint8_t TWISCL1 = 14;
static const uint8_t TWISDA2 = 10;
static const uint8_t TWISCL2 = 9;
#define TWISDA0_SET_MODE (PORT_SELECTION1 | INPUT_PULLUP)
#define TWISCL0_SET_MODE (PORT_SELECTION1 | INPUT_PULLUP)
#define TWISDA1_SET_MODE (PORT_SELECTION0 | INPUT_PULLUP)
#define TWISCL1_SET_MODE (PORT_SELECTION0 | INPUT_PULLUP)
#define TWISDA2_SET_MODE (PORT_SELECTION0 | INPUT_PULLUP)
#define TWISCL2_SET_MODE (PORT_SELECTION0 | INPUT_PULLUP)
#define SPISCK0_SET_MODE  (PORT_SELECTION1)
#define SPIMOSI0_SET_MODE (PORT_SELECTION1)
#define SPIMISO0_SET_MODE (PORT_SELECTION1)
#define SPISCK1_SET_MODE  (PORT_SELECTION0)
#define SPIMOSI1_SET_MODE (PORT_SELECTION0)
#define SPIMISO1_SET_MODE (PORT_SELECTION0)
#define DEFAULT_SPI 1
#define SS     SS1
#define SCK    SCK1
#define MOSI   MOSI1
#define MISO   MISO1
#define SPISCK_SET_MODE  SPISCK1_SET_MODE
#define SPIMOSI_SET_MODE SPIMOSI1_SET_MODE
#define SPIMISO_SET_MODE SPIMISO1_SET_MODE
#define SDCARD_SPI_MODULE 0
#define SDCARD_SS_PIN     SS0
#define SDCARD_MOSI_PIN   MOSI0
#define SDCARD_MISO_PIN   MISO0
#define SDCARD_SCK_PIN    SCK0
#define DEFAULT_I2C 2
#define TWISDA TWISDA2
#define TWISCL TWISCL2
#define TWISDA_SET_MODE  TWISDA2_SET_MODE
#define TWISCL_SET_MODE  TWISCL2_SET_MODE
#endif
#if defined(__MSP430_HAS_EUSCI_A0__) || defined(__MSP430_HAS_EUSCI_A1__)
static const uint8_t DEBUG_UARTRXD = 42;
static const uint8_t DEBUG_UARTTXD = 41;
static const uint8_t AUX_UARTRXD = 3;
static const uint8_t AUX_UARTTXD = 4;
#define DEBUG_UARTRXD_SET_MODE (PORT_SELECTION1 | INPUT)
#define DEBUG_UARTTXD_SET_MODE (PORT_SELECTION1 | OUTPUT)
#define AUX_UARTRXD_SET_MODE (PORT_SELECTION0 | INPUT)
#define AUX_UARTTXD_SET_MODE (PORT_SELECTION0 | OUTPUT)
#define DEBUG_UART_MODULE_OFFSET 0x00
#define AUX_UART_MODULE_OFFSET 0x60
#define SERIAL1_AVAILABLE 1
#endif
static const uint8_t A0  = 43;
static const uint8_t A1  = 44;
static const uint8_t A2  = 2;
static const uint8_t A3  = 6;
static const uint8_t A4  = 27;
static const uint8_t A5  = 28;
static const uint8_t A6  = 128 + 6; // Not available on BoosterPack header
static const uint8_t A7  = 128 + 7; // Not available on BoosterPack header;
static const uint8_t A8  = 47;
static const uint8_t A9  = 31;
static const uint8_t A10 = 32;
static const uint8_t A11 = 33;
static const uint8_t A12 = 23;
static const uint8_t A13 = 24;
static const uint8_t A14 = 25;
static const uint8_t A15 = 26;
static const uint8_t P1_2 = 2;
static const uint8_t P6_1 = 3;
static const uint8_t P6_0 = 4;
static const uint8_t P6_2 = 5;
static const uint8_t P1_3 = 6;
static const uint8_t P5_2 = 7;
static const uint8_t P6_3 = 8;
static const uint8_t P7_1 = 9;
static const uint8_t P7_0 = 10;
static const uint8_t P8_1 = 11;
static const uint8_t P8_2 = 12;
static const uint8_t P8_3 = 13;
static const uint8_t P5_1 = 14;
static const uint8_t P5_0 = 15;
static const uint8_t P5_3 = 17;
static const uint8_t P4_4 = 18;
static const uint8_t P5_7 = 19;
static const uint8_t P3_0 = 23;
static const uint8_t P3_1 = 24;
static const uint8_t P3_2 = 25;
static const uint8_t P3_3 = 26;
static const uint8_t P1_4 = 27;
static const uint8_t P1_5 = 28;
static const uint8_t P4_7 = 29;
static const uint8_t P8_0 = 30;
static const uint8_t P4_1 = 31;
static const uint8_t P4_2 = 32;
static const uint8_t P4_3 = 33;
static const uint8_t P2_5 = 34;
static const uint8_t P2_6 = 35;
static const uint8_t P7_3 = 36;
static const uint8_t P3_4 = 37;
static const uint8_t P3_5 = 38;
static const uint8_t P3_6 = 39;
static const uint8_t P3_7 = 40;
static const uint8_t P2_0 = 41;
static const uint8_t P2_1 = 42;
static const uint8_t P1_0 = 43;
static const uint8_t P1_1 = 44;
static const uint8_t P5_6 = 45;
static const uint8_t P5_5 = 46;
static const uint8_t P4_0 = 47;
static const uint8_t P1_6 = 48;
static const uint8_t P2_2 = 49;
static const uint8_t P1_7 = 50;
static const uint8_t P7_2 = 51;
static const uint8_t PUSH1 = 45;
static const uint8_t PUSH2 = 46;
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
        NOT_ON_ADC,
        NOT_ON_ADC,
        NOT_ON_ADC,
        NOT_ON_ADC,
        NOT_ON_ADC,
        0,
        1,
        NOT_ON_ADC,
        NOT_ON_ADC,
        8,
        NOT_ON_ADC,
        NOT_ON_ADC,
        NOT_ON_ADC,
        NOT_ON_ADC,
};
#endif // #ifdef ARDUINO_MAIN
