travis26pdx/LowPowerSensorSuite/(commit log)

2022-03-04 Add existing file
    [configuration_DO_NOT_DELETE.txt]
2022-03-20 Added endseek() function. Moves pointer to EOF
    After opening an existing file, use "jaffl.endseek()", and the pointer moves to EOF to append next printf
2022-03-22 REV 1
    Fixed tables and directory model. Note: NO2 button disfunctional for now.
2022-03-31 REV 1
    Last year’s GUI required 10 data values to be in the log file to operate correctly, so I modified the GUI code to be able to work with 3 data values (temperature, humidity, N2O).
2022-03-31 REV 2
    Modified last year’s GUI to update the data table every time new data was stored into the log file so that live data could be read.
2022-04-01 REV3
    All Buttons now work correctly. Increased size of graph to match fill in the space.
2022-04-02 REV4
    GUI now displays the seconds in the timestamps instead of just hours and minutes. GUI also now displays all of the dates from the log file where each date displayed on the GUI will span an amount equal to the number of samples that was collected for that date.
2022-04-08 REV4
    Deleted date drop down menu, deleted span button, deleted time scroll bar. Deleted 0's from data table. Graph plots last 10 data values from the log file. Graphs are updated and display live data.
2022-04-22 Update SensorSuiteGUI.py
    Changing the table so that it only shows the last certain amount of values(10). Also, making it so that only the last date is displayed in the table.
2022-05-05 REV6
    The problem with this revision is that for some reason when the GUI is launched and there is less than 36 lines of data in the log file then the graph in the GUI will display N2O data only regardless if the graph is switched to a different sensor. The workaround for this is to comment out lines 162 and 163 in GUI_GRAPHING. The problem with this is that it doesn't update the N2O plot when new data arrives unless the N2O graph button is clicked again. However, the other two graphs (temp and humidity) update just fine.
2022-05-13 REV7
    Fixed GUI according to new sample rates as well as some other small bugs. GUI now displays last 100 pieces of data. Also, changed the null sensor values from 0 to 65535 in order to also account when N2O sensor value 0.
2022-05-13 REV1
    Changed the null sensor values from 0 to 65535 in order to also account when N2O sensor value 0. Temperature gets sampled every 1 minute, Humidity every 2 minutes, and N2O every 10 minutes.
2022-05-27 REV 2
    Added N2O code into the main code (warm up time for N2O sensor is 1 minute). Also added new SD card code into the main code, where millis() function will get stored in the SD card file.
2022-06-10 Upload kicad files for junction board
    [SensorSuiteBoard-B_Cu.gbr, SensorSuiteBoard-B_Mask.gbr, SensorSuiteBoard-B_Paste.gbr, SensorSuiteBoard-B_SilkS.gbr, SensorSuiteBoard-Edge_Cuts.gbr, SensorSuiteBoard-F_Cu.gbr, SensorSuiteBoard-F_Mask.gbr, SensorSuiteBoard-F_Paste.gbr]
2022-06-10 Upload kicad schematic for full system.
    [LPSensorSuite.kicad_pcb, LPSensorSuite.sch]
2022-06-10 Baseboard CAD image. in millimeters.
2022-06-10 upload BOMs
    [Bill of Materials - Build - Sheet1.csv, Bill of Materials - Build.xlsx, Bill of Materials - PCB - Sheet1.csv, Bill of Materials - PCB.xlsx]
